DepartmentOfAlchemy/Incipit11/board/Incipit11/Incipit11/Incipit11.kicad_pcb

## KiCad design board/Incipit11/Incipit11/Incipit11.kicad_pcb (2025-05-14)

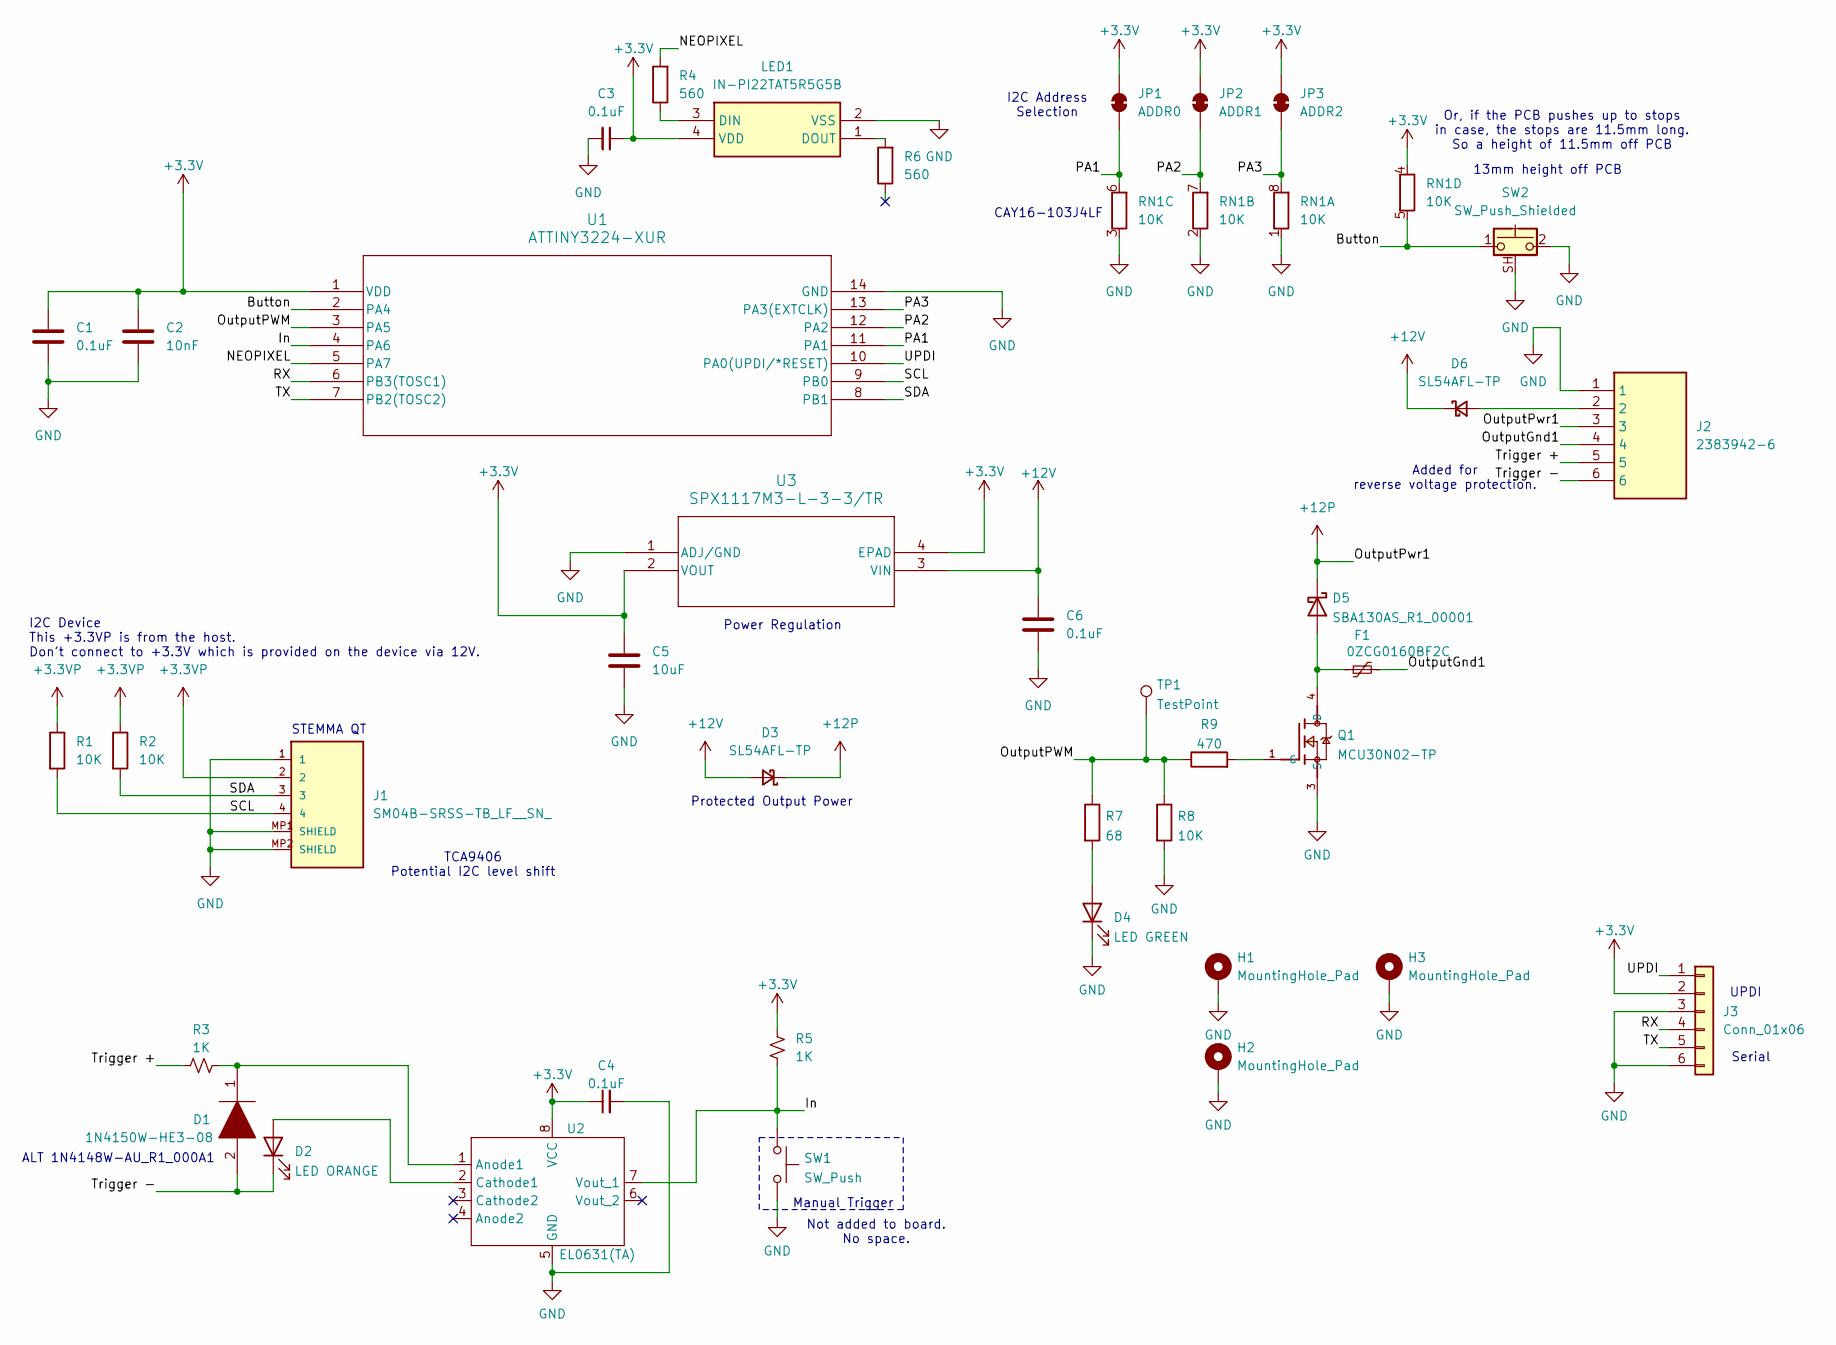
[picture p1: schematic Incipit11.kicad_sch]

Parts:
C1, C3, C4, C6: 0.1uF; C_0603_1608Metric
C2: 10nF; C_0603_1608Metric
C5: 10uF; C_0805_2012Metric
D1: 1N4150W-HE3-08; D_SOD-123; Manufacturer_Part_Number S1GTR
D2: LED ORANGE; LED_0603_1608Metric
D3, D6: SL54AFL-TP; SL54AFL-TP DO-221AC(SMA-FL)
D4: LED GREEN; LED_0603_1608Metric
D5: SBA130AS_R1_00001; D_SOD-123
F1: 0ZCG0160BF2C; Fuse_1812_4532Metric
H1, H2, H3: MountingHole_Pad; MountingHole_2.2mm_M2_ISO7380_Pad_TopBottom
J1: SM04B-SRSS-TB_LF__SN_; JST_SH_BM04B-SRSS-TB_1x04-1MP_P1.00mm_Vertical
J2: 2383942-6; 393570006; Manufacturer_Part_Number 2383942-6; Mouser Part Number 571-2383942-6
J3: Conn_01x06; PinHeader_1x06_P2.54mm_Vertical
JP1: ADDR0; SolderJumper-2_P1.3mm_Bridged_RoundedPad1.0x1.5mm
JP2: ADDR1; SolderJumper-2_P1.3mm_Bridged_RoundedPad1.0x1.5mm
JP3: ADDR2; SolderJumper-2_P1.3mm_Bridged_RoundedPad1.0x1.5mm
LED1: IN-PI22TAT5R5G5B; INPI22TAT5R5G5B; Mouser Part Number 743-IN-PI22TAT5R5G5B
Q1: MCU30N02-TP; TO229P991X239-3N
R1, R2, R8: 10K; R_0603_1608Metric
R3, R5: 1K; R_0603_1608Metric
R4, R6: 560; R_0603_1608Metric
R7: 68; R_0603_1608Metric
R9: 470; R_0603_1608Metric
RN1: 10K; R_Array_Convex_4x0603
SW1: SW_Push; SW_Push_1P1T_NO_RKB2SJK250SMTR LFS
SW2: SW_Push_Shielded; CT1102P
TP1: TestPoint; TestPoint_Pad_D2.5mm
U1: ATTINY3224-XUR; TSSOP14_ST_MCH
U2: EL0631(TA); EL0631(TA)-SOP-8_3.9x4.9mm_P1.27mm
U3: SPX1117M3-L-3-3/TR; SOT223-3_MXL

Connections:
+3.3V: C1.2, C2.2, C3.1, C4.1, C5.1, J3.2, JP1.2 (B), JP2.2 (B), JP3.2 (B), LED1.4 (VDD), R5.2, RN1.4 (R4.1), U1.1 (VDD), U2.8 (VCC), U3.2 (VOUT), U3.4 (EPAD)
+3.3VP: J1.2, R1.1, R2.1
+12P: D3.1 (K), D5.1 (K), J2.3
+12V: C6.1, D3.2 (A), D6.1 (K), U3.3 (VIN)
/Button: RN1.5 (R4.2), SW2.1, U1.2 (PA4)
/In: R5.1, SW1.1, U1.4 (PA6), U2.7 (Vout_1)
/NEOPIXEL: R4.2, U1.5 (PA7)
/OutputGnd1: F1.2, J2.4
/OutputPWM: R7.1, R8.1, R9.1, TP1.1, U1.3 (PA5)
/PA1: JP1.1 (A), RN1.6 (R3.2), U1.11 (PA1)
/PA2: JP2.1 (A), RN1.7 (R2.2), U1.12 (PA2)
/PA3: JP3.1 (A), RN1.8 (R1.2), U1.13 (PA3(EXTCLK))
/RX: J3.4, U1.6 (PB3(TOSC1))
/SCL: J1.4, R1.2, U1.9 (PB0)
/SDA: J1.3, R2.2, U1.8 (PB1)
/TX: J3.5, U1.7 (PB2(TOSC2))
/Trigger +: J2.5, R3.2
/Trigger -: D1.2, D2.1 (K), J2.6
/UPDI: J3.1, U1.10 (PA0(UPDI/*RESET))
GND: C1.1, C2.1, C3.2, C4.2, C5.2, C6.2, D4.1 (K), H1.1, H2.1, H3.1, J1.1, J1.MP1 (SHIELD), J1.MP2 (SHIELD), J2.1, J3.3, J3.6, LED1.2 (VSS), Q1.3 (S), R8.2, RN1.1 (R1.1), RN1.2 (R2.1), RN1.3 (R3.1), SW1.2, SW2.2, SW2.SH (B), U1.14 (GND), U2.5 (GND), U3.1 (ADJ/GND)
unnamed: D2.2 (A), U2.2 (Cathode1)
unnamed: D4.2 (A), R7.2
unnamed: D5.2 (A), F1.1, Q1.4 (D)
unnamed: D6.2 (A), J2.2
unnamed: LED1.3 (DIN), R4.1
unnamed: LED1.1 (DOUT), R6.2
unnamed: Q1.1 (G), R9.2
unnamed: D1.1, R3.1, U2.1 (Anode1)

Notes on the sheet:
UPDI
Or, if the PCB pushes up to stops in case, the stops are 11.5mm long. So a height of 11.5mm off PCB
ALT 1N4148W-AU_R1_000A1
Manual Trigger
STEMMA QT
TCA9406 Potential I2C level shift
Power Regulation
13mm height off PCB
Added for reverse voltage protection.
Protected Output Power
Serial
I2C Device This +3.3VP is from the host. Don't connect to +3.3V which is provided on the device via 12V.
CAY16-103J4LF
Not added to board. No space.
I2C Address Selection

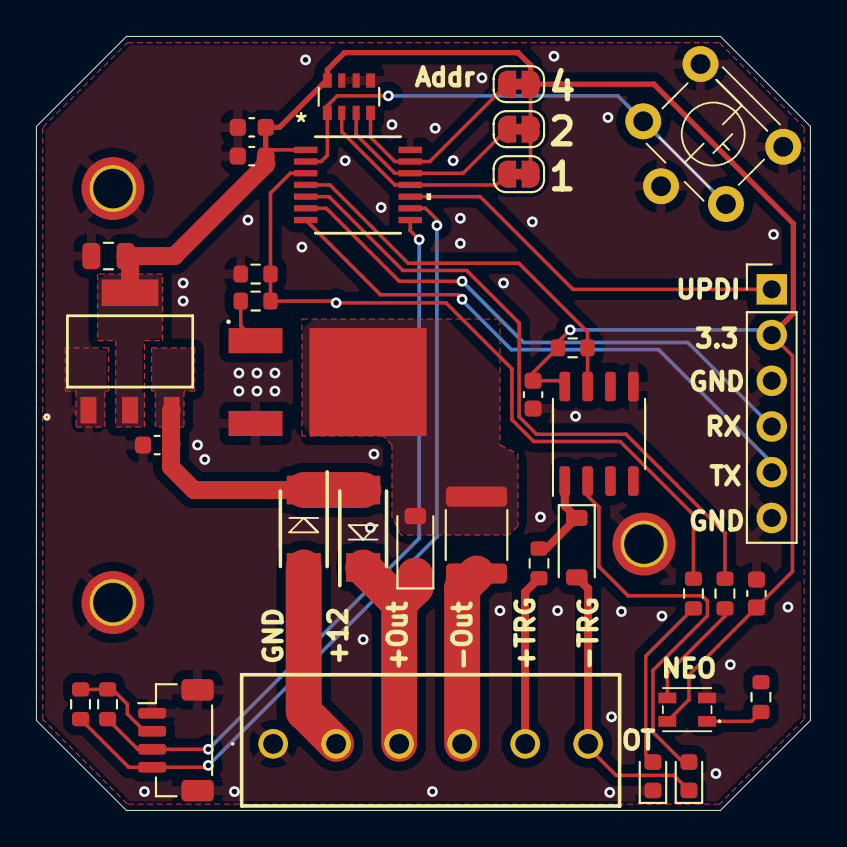
[picture p2: board Incipit11.kicad_pcb from above]

Board: 2 copper layers, 43.0 x 43.0 mm, 39 parts (1 on the bottom side), 28 nets.
