DepartmentOfAlchemy/Incipit11/arduino/Incipit11Controller/Effect.h

#ifndef Effect_h
#define Effect_h

#include "Arduino.h"

// Gamma brightness lookup table <https://victornpb.github.io/gamma-table-generator>
// gamma = 2.20 steps = 256 range = 0-255
const uint8_t gamma_lut[256] = {
     0,   0,   0,   0,   0,   0,   0,   0,   0,   0,   0,   0,   0,   0,   0,   1,
     1,   1,   1,   1,   1,   1,   1,   1,   1,   2,   2,   2,   2,   2,   2,   2,
     3,   3,   3,   3,   3,   4,   4,   4,   4,   5,   5,   5,   5,   6,   6,   6,
     6,   7,   7,   7,   8,   8,   8,   9,   9,   9,  10,  10,  11,  11,  11,  12,
    12,  13,  13,  13,  14,  14,  15,  15,  16,  16,  17,  17,  18,  18,  19,  19,
    20,  20,  21,  22,  22,  23,  23,  24,  25,  25,  26,  26,  27,  28,  28,  29,
    30,  30,  31,  32,  33,  33,  34,  35,  35,  36,  37,  38,  39,  39,  40,  41,
    42,  43,  43,  44,  45,  46,  47,  48,  49,  49,  50,  51,  52,  53,  54,  55,
    56,  57,  58,  59,  60,  61,  62,  63,  64,  65,  66,  67,  68,  69,  70,  71,
    73,  74,  75,  76,  77,  78,  79,  81,  82,  83,  84,  85,  87,  88,  89,  90,
    91,  93,  94,  95,  97,  98,  99, 100, 102, 103, 105, 106, 107, 109, 110, 111,
   113, 114, 116, 117, 119, 120, 121, 123, 124, 126, 127, 129, 130, 132, 133, 135,
   137, 138, 140, 141, 143, 145, 146, 148, 149, 151, 153, 154, 156, 158, 159, 161,
   163, 165, 166, 168, 170, 172, 173, 175, 177, 179, 181, 182, 184, 186, 188, 190,
   192, 194, 196, 197, 199, 201, 203, 205, 207, 209, 211, 213, 215, 217, 219, 221,
   223, 225, 227, 229, 231, 234, 236, 238, 240, 242, 244, 246, 248, 251, 253, 255,
  };

const uint8_t sineLookupTable[] = {
   128, 136, 143, 151, 159, 167, 174, 182,
   189, 196, 202, 209, 215, 220, 226, 231,
   235, 239, 243, 246, 249, 251, 253, 254,
   255, 255, 255, 254, 253, 251, 249, 246,
   243, 239, 235, 231, 226, 220, 215, 209,
   202, 196, 189, 182, 174, 167, 159, 151,
   143, 136, 128, 119, 112, 104,  96,  88,
    81,  73,  66,  59,  53,  46,  40,  35,
    29,  24,  20,  16,  12,   9,   6,   4,
     2,   1,   0,   0,   0,   1,   2,   4,
     6,   9,  12,  16,  20,  24,  29,  35,
    40,  46,  53,  59,  66,  73,  81,  88,
    96, 104, 112, 119,
  };

const uint8_t sineLookupTableLength = 100;

const uint8_t heartbeatStart = 76;
const uint8_t heartbeatEnd   = 74;

const uint8_t heartbeatLookupTableLength = 99;

const unsigned long MILLISECONDS_PER_SECOND = 1000;

class Effect {
public:
  Effect(uint8_t pin) : _pin(pin) {
    _brightness = 0;
  }

  uint8_t getPin() {
    return _pin;
  }

  virtual uint8_t getBrightness() {
    return _brightness;
  }

  virtual void setBrightness(uint8_t brightness) {
    _brightness = brightness;
  }

  virtual void enter() {
    // no-op
  }

  virtual void exit() {
    // no-op
  }

  virtual void update(unsigned long now = 0) = 0;

  virtual ~Effect() {}

protected:
  uint8_t _pin;
  uint8_t _brightness;
};

class Dimmer : public Effect {
public:
  Dimmer(uint8_t pin) : Effect(pin) {
    _brightness = 0;
    _strobe = 0;
    transitionPeriod = 0;
    lastTransitionTime = 0;
    nextTransition = true;

    // initialize to off
    analogWrite(_pin, _brightness);
    _lastBrightness = _brightness;
  }

  uint16_t getStrobe() {
    return _strobe;
  }

  void setStrobe(uint16_t frequency) {
    if (frequency > 1400) {
      frequency = 1400;
    }
    _strobe = frequency;

    if (frequency > 0) {
      // convert frequency into transition period
      // (period is equally divided to half off/half on)
      transitionPeriod = (MILLISECONDS_PER_SECOND / frequency) / 2;
    }
  }

  void enter() override {
    // set to turn on if strobing on next update()
    lastTransitionTime = 0;
    nextTransition = true;

    _lastBrightness = 0;
    // edge condition
    // in update, since _brightness == _lastBrightness it would never set the output off
    if (_brightness == 0) {
      analogWrite(_pin, _brightness);
    }
  }

  void update(unsigned long now = 0) override {
    if (_strobe == 0) {
      // constrant
      if (_lastBrightness != _brightness) {
        analogWrite(_pin, gamma_lut[_brightness]);
        _lastBrightness = _brightness;
      }
    } else {
      // strobing
      if (now == 0) {
        now = millis();
      }

      if (now >= (lastTransitionTime + transitionPeriod)) {
        lastTransitionTime = now;
        // transition between on/off
        if (nextTransition) {
          analogWrite(_pin, gamma_lut[_brightness]);
          _lastBrightness = _brightness;
        } else {
          analogWrite(_pin, 0);
          _lastBrightness = 0;
        }

        nextTransition = !nextTransition;
      }
    }
  }

  ~Dimmer() override {}

protected:
  uint8_t _lastBrightness;
  uint16_t _strobe;
  unsigned long transitionPeriod;
  unsigned long lastTransitionTime;
  bool nextTransition;
};

class Sparkle : public Effect {
public:
  Sparkle(uint8_t pin) : Effect(pin) {
    _brightness = 0;
    _intensity = 0;
    transitionPeriod = 0;
    lastTransitionTime = 0;
    sparkleOn = true;

    // initialize to off
    analogWrite(_pin, _brightness);
    _lastBrightness = _brightness;
  }

  uint8_t getIntensity() {
    return _intensity;
  }

  void setIntensity(uint8_t intensity) {
    if (intensity > 5) {
      intensity = 5;
    }
    _intensity = intensity;
  }

  void enter() override {
    // set to turn on if strobing on next update()
    lastTransitionTime = 0;
    sparkleOn = true;

    _lastBrightness = 0;
    // edge condition
    // in update, since _brightness == _lastBrightness it would never set the output off
    if (_brightness == 0) {
      analogWrite(_pin, _brightness);
    }
  }

  void update(unsigned long now = 0) override {
    uint16_t min;
    uint16_t max;

    if (_intensity == 0) {
      // constant
      if (_lastBrightness != _brightness) {
        analogWrite(_pin, gamma_lut[_brightness]);
        _lastBrightness = _brightness;
      }
    } else {
      // sparkling
      if (now == 0) {
        now = millis();
      }

      if (now >= (lastTransitionTime + transitionPeriod)) {
        lastTransitionTime = now;
        // transition between on/off
        if (sparkleOn) {
          analogWrite(_pin, gamma_lut[_brightness]);
          _lastBrightness = _brightness;
          if (_intensity == 1) {
            min = 20; // 20ms
            max = 75; // 75ms
          } else if (_intensity == 2) {
            min = 20;  // 20ms
            max = 100; // 100ms
          } else {
            min = 30;  // 30ms
            max = 200; // 200ms
          }
          transitionPeriod = random(min, max); // Random ON duration (30ms to 200ms)
          sparkleOn = false; // turn off after transition period
        } else {
          analogWrite(_pin, 0);
          _lastBrightness = 0;
          if (_intensity == 1) {
            min = 200; // 200ms
            max = 1000; // 1000ms
          } else if (_intensity == 2) {
            min = 60;  // 60ms
            max = 400; // 400ms
          } else {
            min = 50;  // 50ms
            max = 300; // 300ms
          }
          transitionPeriod = random(min, max); // Random OFF duration (50ms to 300ms)
          sparkleOn = true; // turn on after transition period
        }
      }
    }
  }

  ~Sparkle() override {}

protected:
  uint8_t _lastBrightness;
  uint8_t _intensity;
  unsigned long transitionPeriod;
  unsigned long lastTransitionTime;
  bool sparkleOn;
};

class FlickerOff : public Effect {
public:
  FlickerOff(uint8_t pin) : Effect(pin) {
    _brightness = 255;
    transitionPeriod = 60;
    lastTransitionTime = 0;

    // initialize to off
    analogWrite(_pin, _brightness);
    _lastBrightness = _brightness;
  }

  uint8_t getPeriod() {
    return transitionPeriod;
  }

  void setPeriod(uint8_t period) {
    transitionPeriod = period;
  }

  void enter() override {
    // set to turn on if strobing on next update()
    lastTransitionTime = 0;

    _lastBrightness = 0;
    // edge condition
    // in update, since _brightness == _lastBrightness it would never set the output off
    if (_brightness == 0) {
      analogWrite(_pin, _brightness);
    }
  }

  void update(unsigned long now = 0) override {
    uint8_t brightness;
    uint8_t dim; // dimming value

    if (now >= (lastTransitionTime + transitionPeriod)) {
      lastTransitionTime = now;

      dim = 255 - _brightness;
      if (dim > 135) {
        // don't let brightness go below 0 because it is unsigned
        dim = 135;
      }
      brightness = random(120) + 135 - dim;
      analogWrite(_pin, gamma_lut[brightness]);
      _lastBrightness = brightness;
    }
  }

  ~FlickerOff() override {}

protected:
  uint8_t _lastBrightness;
  unsigned long transitionPeriod;
  unsigned long lastTransitionTime;
};

class FlickerOn : public Effect {
public:
  FlickerOn(uint8_t pin) : Effect(pin) {
    _brightness = 255;
    // i = 15, t = 10 looks good
    _intensity = 45;
    _threshold = 30;
    _baseBrightness = 0;
    transitionPeriod = 60;
    lastTransitionTime = 0;

    // initialize to off
    analogWrite(_pin, _brightness);
    _lastBrightness = _brightness;
  }

  uint8_t getPeriod() {
    return transitionPeriod;
  }

  void setPeriod(uint8_t period) {
    transitionPeriod = period;
  }

  uint8_t getIntensity() {
    return _intensity;
  }

  void setIntensity(uint8_t intensity) {
    _intensity = intensity;
  }

  uint8_t getThreshold() {
    return _threshold;
  }

  void setThreshold(uint8_t threshold) {
    _threshold = threshold;
  }

  uint8_t getBaseBrightness() {
    return _baseBrightness;
  }

  void setBaseBrightness(uint8_t baseBrightness) {
    _baseBrightness = baseBrightness;
  }

  void enter() override {
    // set to turn on if strobing on next update()
    lastTransitionTime = 0;

    _lastBrightness = 0;
    // edge condition
    // in update, since _brightness == _lastBrightness it would never set the output off
    if (_brightness == 0) {
      analogWrite(_pin, _brightness);
    }
  }

  void update(unsigned long now = 0) override {
    uint8_t brightness;
    uint8_t offset;
    uint8_t baseBrightness;

    if (now >= (lastTransitionTime + transitionPeriod)) {
      lastTransitionTime = now;

      baseBrightness = min(_baseBrightness, _brightness);
      brightness = random(_intensity);

      if (brightness < _threshold) {
        brightness = baseBrightness;
      } else {
        if (_intensity < _brightness) {
          offset = _brightness - _intensity;
        } else {
          offset = 0;
        }
        brightness = brightness + offset;
      }

      analogWrite(_pin, gamma_lut[brightness]);
      _lastBrightness = brightness;
    }
  }

  ~FlickerOn() override {}

protected:
  uint8_t _lastBrightness;
  uint8_t _intensity;
  uint8_t _threshold;
  uint8_t _baseBrightness;
  unsigned long transitionPeriod;
  unsigned long lastTransitionTime;
};

class SineWave : public Effect {
public:
  SineWave(uint8_t pin) : Effect(pin) {
    _brightness = 0;
    _frequency = 0;
    _denominator = 1;
    _minimumBrightness = 0;
    transitionPeriod = 0;
    lastTransitionTime = 0;
    index = 0;

    // initialize to off
    analogWrite(_pin, _brightness);
    _lastBrightness = _brightness;
  }

  uint16_t getFrequency() {
    return _frequency;
  }

  void setFrequency(uint16_t frequency, uint8_t denominator = 1) {
    if (frequency > 1400) {
      frequency = 1400;
    }
    _frequency = frequency;
    _denominator = denominator;

    if (frequency > 0) {
      // convert frequency into transition period
      // (period is equally divided into 100 points in lookup table)
      transitionPeriod = (MILLISECONDS_PER_SECOND / frequency) / (sineLookupTableLength / denominator);
    }
  }

  uint8_t getFrequencyDenominator() {
    return _denominator;
  }

  void setMinimumBrightness(uint8_t minimumBrightness) {
    _minimumBrightness = minimumBrightness;
  }

  uint8_t getMinimumBrightness() {
    return _minimumBrightness;
  }

  void enter() override {
    // set to turn on if strobing on next update()
    lastTransitionTime = 0;

    index = 0;

    _lastBrightness = 0;
    // edge condition
    // in update, since _brightness == _lastBrightness it would never set the output off
    if (_brightness == 0) {
      analogWrite(_pin, _brightness);
    }
  }

  void update(unsigned long now = 0) override {
    uint8_t actualBrightness;

    if (_frequency == 0) {
      // constant
      if (_lastBrightness != _brightness) {
        analogWrite(_pin, gamma_lut[_brightness]);
        _lastBrightness = _brightness;
      }
    } else {
      // sine output
      if (now == 0) {
        now = millis();
      }

      if (now >= (lastTransitionTime + transitionPeriod)) {
        lastTransitionTime = now;

        actualBrightness = sineLookupTable[index];
        if (actualBrightness < _minimumBrightness) {
          actualBrightness = _minimumBrightness;
        }

        analogWrite(_pin, gamma_lut[actualBrightness]);
        _lastBrightness = actualBrightness;

        index++;
        if (index >= sineLookupTableLength) {
          index = 0;
        }
      }
    }
  }

  ~SineWave() override {}

protected:
  uint8_t _lastBrightness;
  uint16_t _frequency;
  uint8_t _denominator;
  uint8_t _minimumBrightness;
  unsigned long transitionPeriod;
  unsigned long lastTransitionTime;
  uint8_t index;
};

class Heartbeat : public Effect {
public:
  Heartbeat(uint8_t pin) : Effect(pin) {
    _brightness = 0;
    frequency = 2; // hardcoded frequency of beats
    transitionPeriod = 0;
    lastTransitionTime = 0;
    index = heartbeatStart;
    beats = 2; // number of sequential beats
    beat = 0;  // keep track of which beat
    _space = 2000; // default to 2 second interval between beats

    // convert frequency into transition period
    // (period is equally divided into 100 points in lookup table)
    transitionPeriod = (MILLISECONDS_PER_SECOND / frequency) / 99;

    // initialize to off
    analogWrite(_pin, _brightness);
    _lastBrightness = _brightness;
  }

  uint32_t getSpace() {
    return _space;
  }

  void setSpace(uint32_t space) {
    _space = space;
  }

  void enter() override {
    // set to turn on if strobing on next update()
    lastTransitionTime = 0;

    index = heartbeatStart;
    beat = 0;

    _lastBrightness = 0;
    // edge condition
    // in update, since _brightness == _lastBrightness it would never set the output off
    if (_brightness == 0) {
      analogWrite(_pin, _brightness);
    }
  }

  void update(unsigned long now = 0) override {
    if (frequency == 0) {
      // constant
      if (_lastBrightness != _brightness) {
        analogWrite(_pin, gamma_lut[_brightness]);
        _lastBrightness = _brightness;
      }
    } else {
      // heartbeat output
      if (now == 0) {
        now = millis();
      }

      if (beat < beats) {
        // heartbeat
        if (now >= (lastTransitionTime + transitionPeriod)) {
          lastTransitionTime = now;

          analogWrite(_pin, gamma_lut[sineLookupTable[index]]);
          _lastBrightness = sineLookupTable[index];

          index++;
          if (index >= heartbeatLookupTableLength) {
            index = 0;
          }

          if (index == heartbeatEnd) {
            beat++;
            index = heartbeatStart;
          }
        }
      } else {
        // space
        if (_lastBrightness != _brightness) {
          analogWrite(_pin, gamma_lut[_brightness]);
          _lastBrightness = _brightness;
        }

        if (now >= (lastTransitionTime + _space)) {
          // end of space
          lastTransitionTime = now;

          beat = 0;
          index = heartbeatStart; // for good measure
        }
      }
    }
  }

  ~Heartbeat() override {}

protected:
  uint8_t _lastBrightness;
  uint16_t frequency;
  unsigned long transitionPeriod;
  unsigned long lastTransitionTime;
  uint32_t _space;
  uint8_t index;
  uint8_t beats;
  uint8_t beat;
};
#endif
