DepartmentOfAlchemy/Incipit11/(commit log)

2025-04-12 Rev A of the project.
    [Incipit11-B_Cu.gbl, Incipit11-B_Mask.gbs, Incipit11-B_Paste.gbp, Incipit11-B_Silkscreen.gbo, Incipit11-Edge_Cuts.gm1, Incipit11-F_Cu.gtl, Incipit11-F_Mask.gts, Incipit11-F_Paste.gtp]
2025-05-14 Rev B of board for new case. Did a few modifications to add more reverse protection on output and changed the I2C to seperate the 3.3 power from controller and peripheral.
    [Incipit11-B_Cu.gbl, Incipit11-B_Mask.gbs, Incipit11-B_Paste.gbp, Incipit11-B_Silkscreen.gbo, Incipit11-Edge_Cuts.gm1, Incipit11-F_Cu.gtl, Incipit11-F_Mask.gts, Incipit11-F_Paste.gtp]
2026-02-01 Updates to support using the Incipit 11 (Rev C) as an Adafruit Seesaw peripheral. Basic functionality works. The SeesawTest Arduino program was used to test the basic functionality.
2026-02-03 Renamed Flicker effect to FlickerOff and added a FlickerOn effect. Refactored setting Seesaw communicated PWM and reset to registered callback functions instead of global variables. Refectored cyclin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
    [DOA_seesawCompatibility.h, Effect.h, Incipit11Controller.ino]
2026-02-05 Added Sine Wave and Heartbeat effects. Added Seesaw peripheral support to read/write the ambient effect, triggered effect, and triggered effect length. Also added Seesaw peripheral support for activi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
